huyhoang-1501/Graduation_Thesis/assets/block_diagram.png

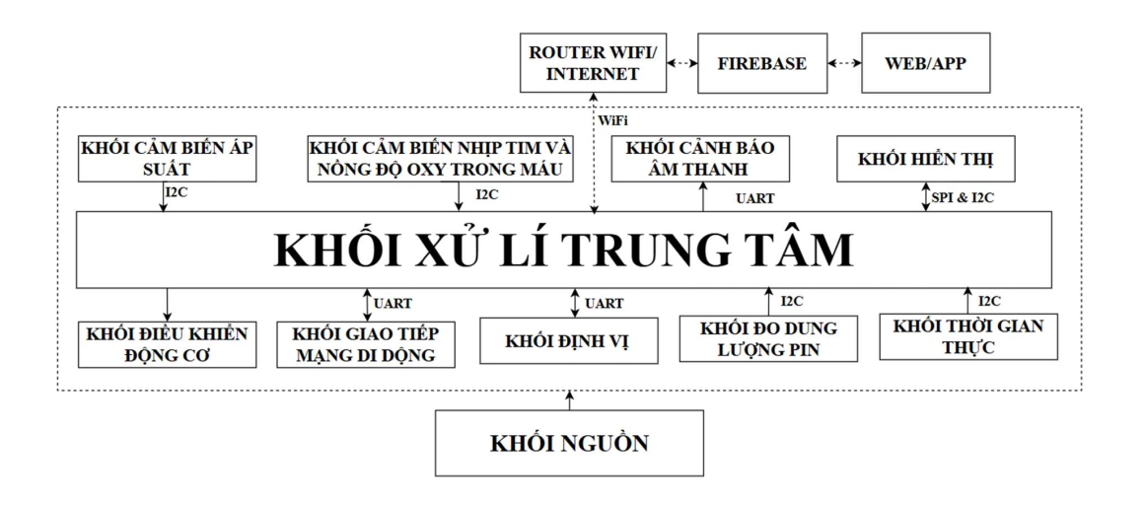
assets/block_diagram.png
