huyhoang-1501/Graduation_Thesis/assets/idea.webp

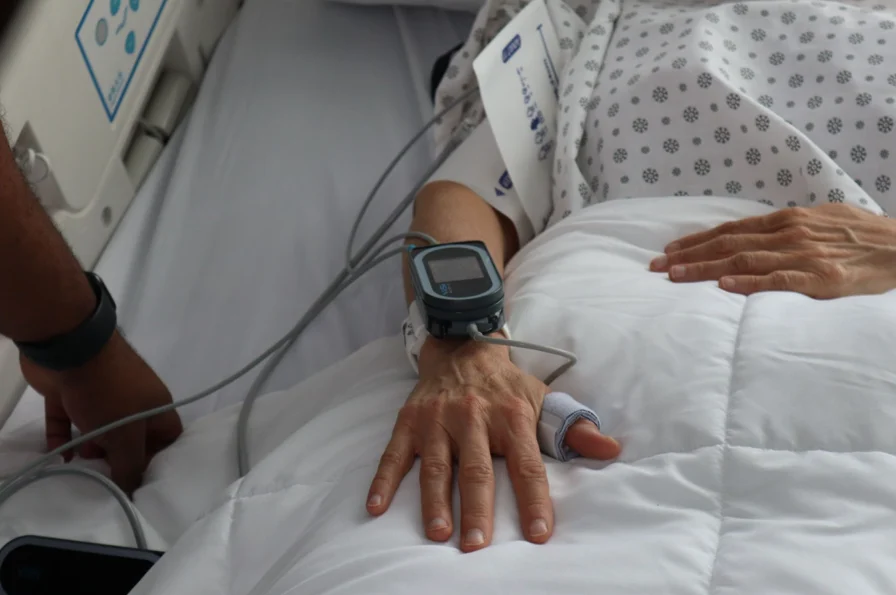
assets/idea.webp
