huyhoang-1501/Graduation_Thesis/assets/Machhoanthien.png

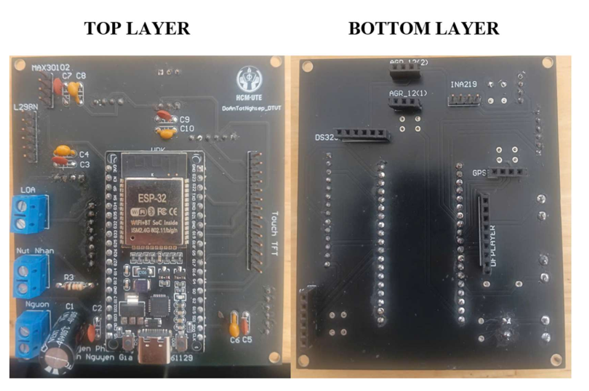
assets/Machhoanthien.png
