huyhoang-1501/Graduation_Thesis/assets/overview.jpg

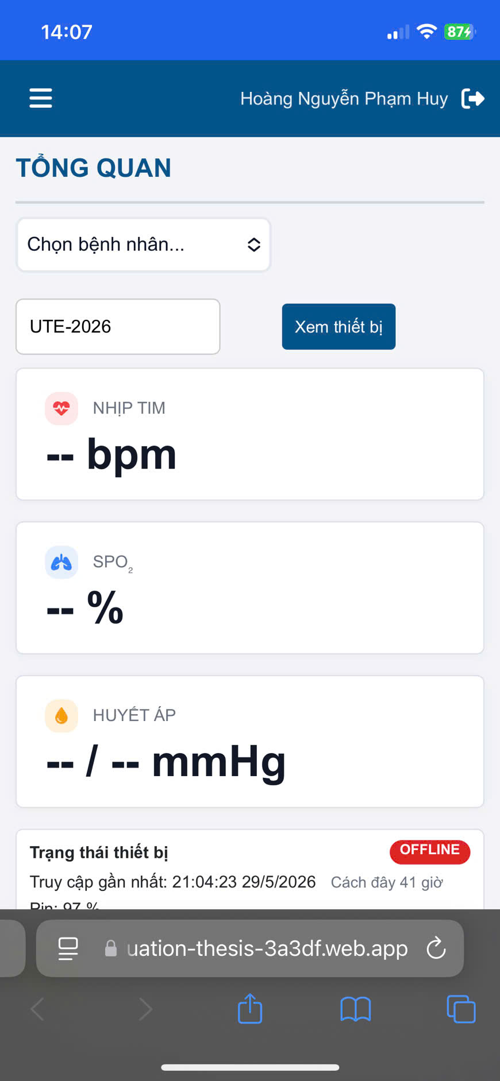
assets/overview.jpg
