huyhoang-1501/Graduation_Thesis/assets/Poster.png

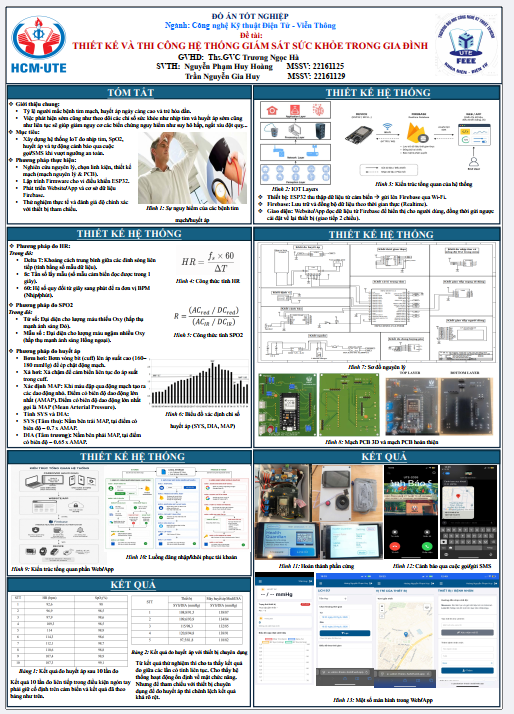
assets/Poster.png
