huyhoang-1501/Graduation_Thesis/WEB/image/healthcare.png

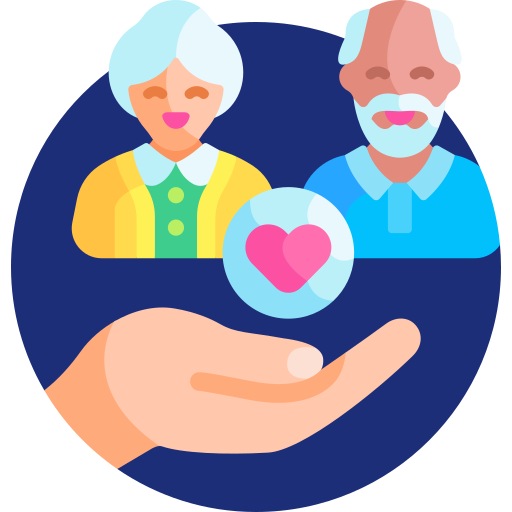
WEB/image/healthcare.png
