huyhoang-1501/Graduation_Thesis/Schematic/Schematic_Graduation_Thesis/Schematic.pdf

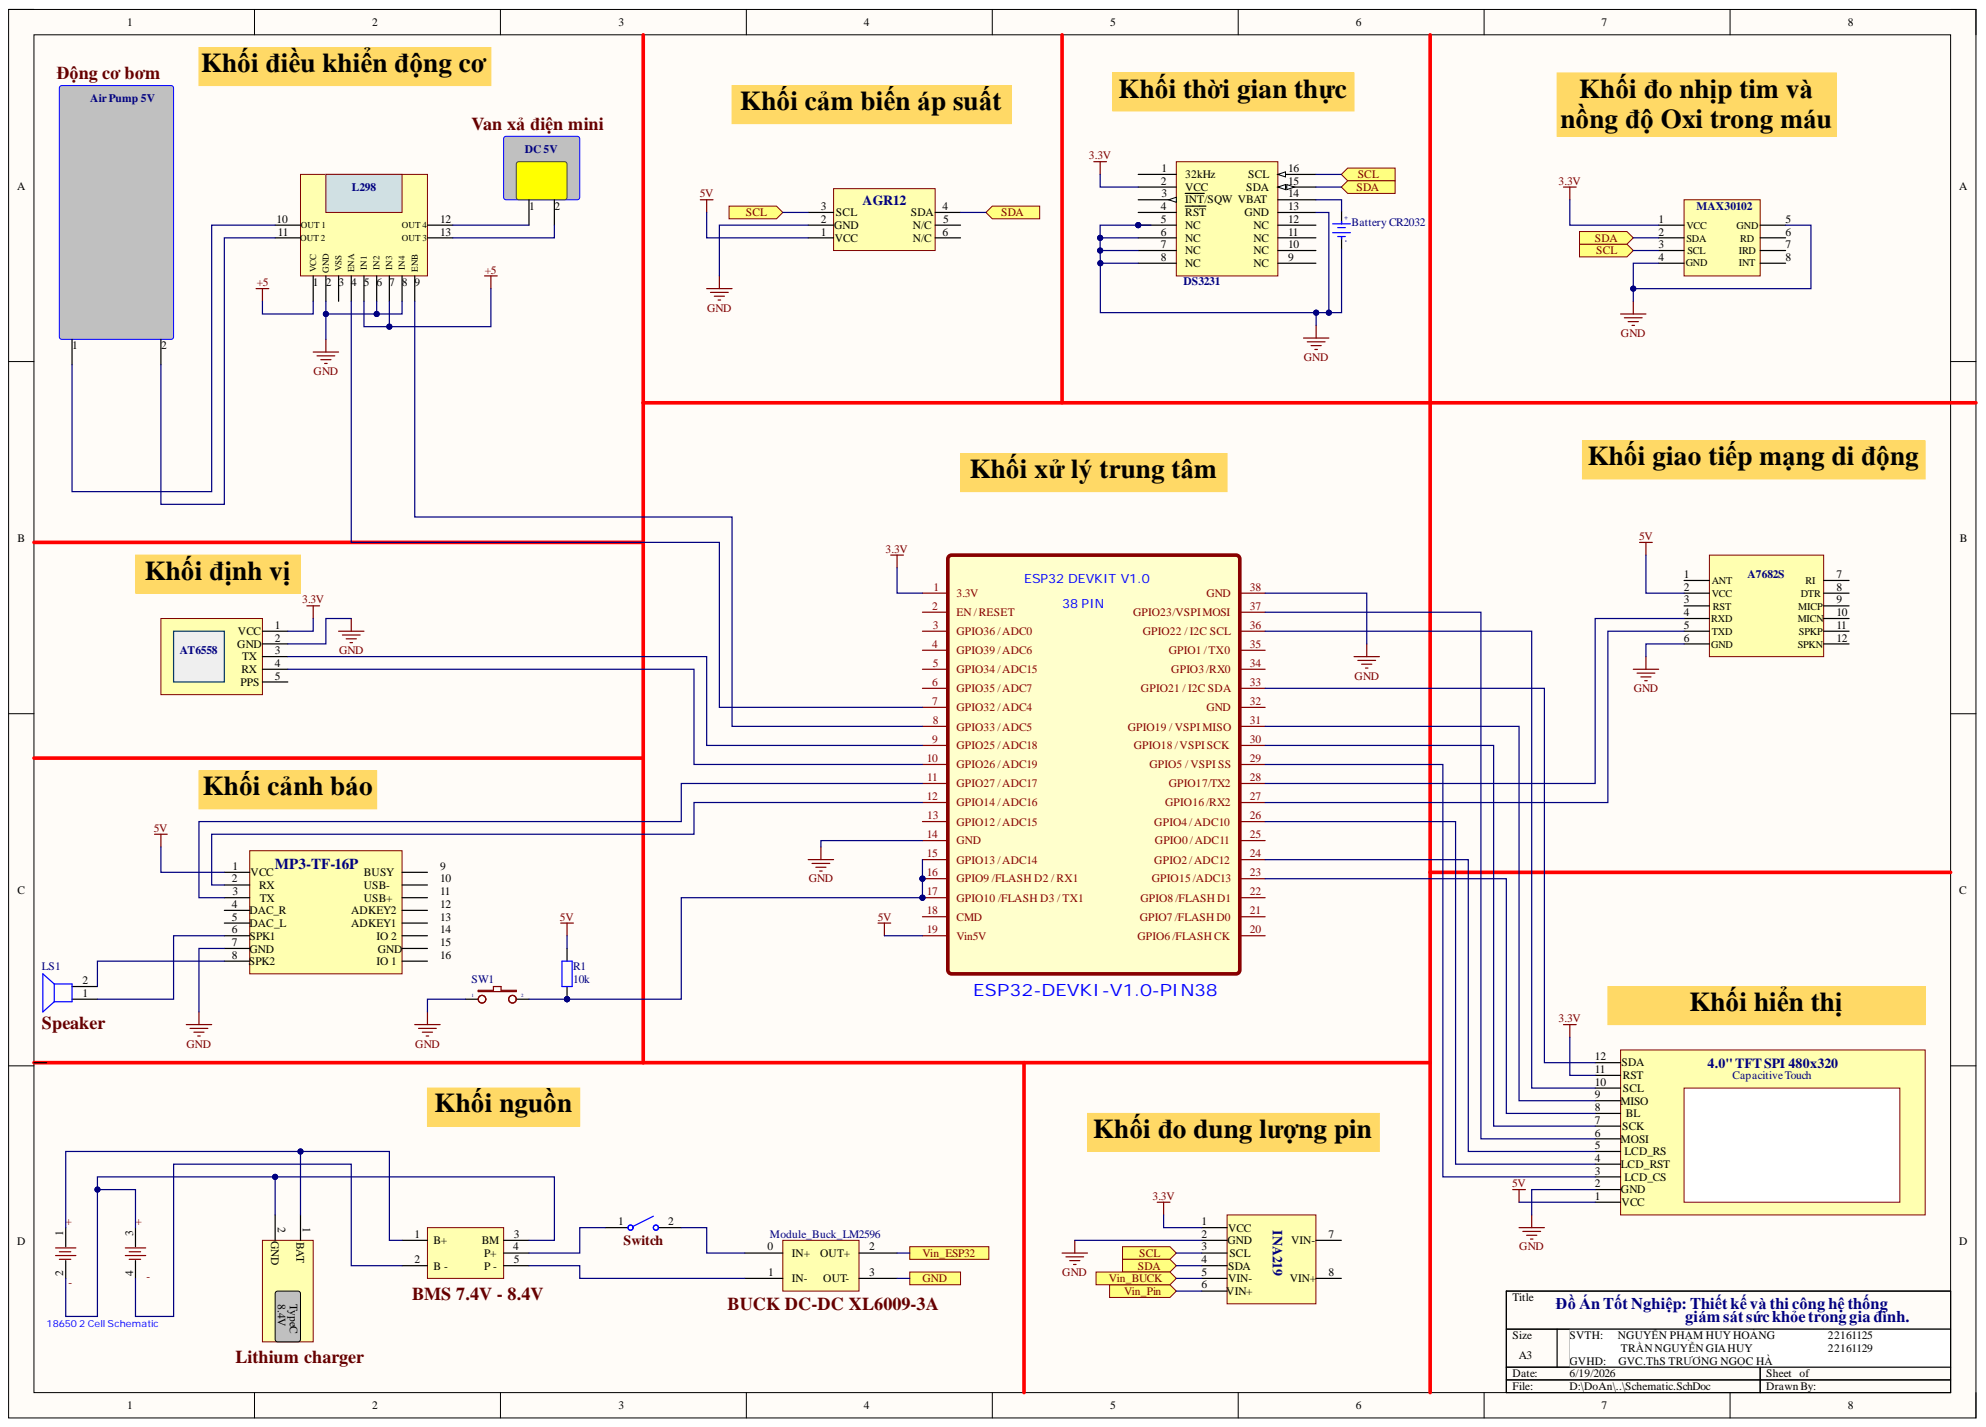
[picture p25: page 1]

Khối điều khiển động cơ

Khối thời gian thực

Khối đo nhịp tim và
nồng độ Oxi trong máu

Khối cảm biến áp suất

Van xả điện mini

GND

Khối giao tiếp mạng di động Khối xử lý trung tâm

Khối đo dung lượng pin | | 7

Title
Đồ Án Tốt Nghiệp: Thiết kế và thi công hệ thống giám sát sức khỏe trong gia đình.

Size A3 | | SVTH: Number NGUYỄN PHẠM HUY HOÀNG TRẦN NGUYỄN GIAHUY GVHD: GVC.ThS TRƯƠNG NGỌC HÀ | 22161125 Revision 22161129

Date: 6/19/2026 | Sheet of
File: D:\DoAn\..\Schematic.SchDoc | Drawn By:
