huyhoang-1501/Graduation_Thesis/(list of files, drawings)

Other design files:
PCB/PCB_Graduation_Thesis/PCB.PcbDoc
PCB/PCB_Graduation_Thesis/PCB_Graduation_Thesis.PrjPcb
PCB/PCB_Graduation_Thesis/Sheet.SchDoc
Schematic/Schematic_Graduation_Thesis/Schematic.SchDoc
