huyhoang-1501/Graduation_Thesis/(commit log)

2026-03-29 Enhance Gui and Pin Map On Telegram
2026-04-04 Add function for History/Alert/Device-Setting
2026-04-08 Add function reading battery capacity
    [Schematic_Graduation_Thesis.PrjPcb]
2026-04-13 Add documentions
    [FT6336U_Register.xlsx]
2026-04-16 Add keypad when click User
    [Schematic.SchDoc, Schematic_Graduation_Thesis.PrjPcb]
2026-04-19 Add code read data ECG from ADS8232 and create module schematic
    [Schematic.SchDoc]
2026-04-21 Add function select patient in the setting
2026-04-21 Replace a single-cell battery with a dual-cell battery.
    [Schematic.SchDoc]
2026-04-21 Add event when press the Guest button on the Main Gui
2026-04-21 Add layout for button Back in the keypad
2026-04-21 Fix the time error on DS3231
    [Main_Gui.ino]
2026-04-21 Develop logic to pair the device with the dashboard
2026-04-22 Remove the mechanism that links the device to the web
2026-04-23 Sync Device with RTDB
2026-04-23 Fix HTTP blocking issues and use thread splitting to optimize task execution
    [FirebaseSync.cpp, Main_Gui.ino, UserMode.cpp]
2026-04-24 Remove the option to deploy on Git
    [Config.txt]
2026-04-24 Optimized interface for mobile devices
2026-04-26 Add the algorithm presentation file for the MAX3010X sensor
2026-04-27 Add module MAX30102 on Altium
    [Schematic.SchDoc]
2026-04-28 Verify email when log in
    [Schematic.SchDoc]
2026-04-28 Complete the Schematic
    [Schematic.SchDoc]
2026-04-28 Add file PDF of Schematic
    [Schematic.SchDoc]
2026-04-29 Adjust the pins for the SIM module, GPS module, alarm unit, and blood pressure measurement unit
    [Schematic.SchDoc, Schematic_Graduation_Thesis.PrjPcb]
2026-04-29 Define pins of battery capacity measurement module and heart rate and SPO2 measurement module
    [PCB.PcbDoc, PCB_Graduation_Thesis.PrjPcb, Schematic.SchDoc, Sheet.SchDoc]
2026-04-29 Add schematic of DS3231
    [Schematic.SchDoc, Sheet.SchDoc]
2026-04-30 Implement PCB
    [PCB.PcbDoc, Schematic.SchDoc, Sheet.SchDoc]
2026-05-03 Update PCB
    [PCB.PcbDoc, PCB_Graduation_Thesis.PrjPcb, Sheet.SchDoc]
2026-05-03 Update PCB V2
    [PCB_Graduation_Thesis.PrjPcb, Sheet.SchDoc]
2026-05-04 Adjust the layout for the edit alert button cluster
2026-05-06 Copper overlay and Gerber file export
    [PCB.GBL, PCB.GBO, PCB.GBP, PCB.GBS, PCB.GKO, PCB.GTL, PCB.GTO, PCB.GTP]
2026-05-07 Customize the interface of the buttons on mobile devices
2026-05-08 Add two resistors to the TX and RX pins of DFPlayer
    [PCB.PcbDoc, Sheet.SchDoc]
2026-05-10 Scale data input fields on mobile
    [PCB.PcbDoc, Sheet.SchDoc]
2026-05-10 Add a materials and components list
    [Vatulinhkien_DATN.xlsx]
2026-05-10 Adjust the height of the data entry fields in the Devices/Patients section
2026-05-10 Add function read BP, HR, SPO2 on Main Gui
    [PCB.PcbDoc, Sheet.SchDoc, Vatulinhkien_DATN.xlsx]
2026-05-10 Reduce the size of the cells in the device/patient
2026-05-10 Add button Start on Guest and User mode
2026-05-10 Change the position of the start and settings buttons
2026-05-11 Export File Gerber
    [PCB.GBL, PCB.GBO, PCB.GBP, PCB.GBS, PCB.GKO, PCB.GTL, PCB.GTO, PCB.GTP]
2026-05-11 Disable Start button to avoid re-entrancy while measurement runs
    [GuestMode.cpp]
2026-05-12 Remove the Start button logic and delete the virtual display of parameters on the TFT screen
2026-05-12 Remove the 3 modes and switch to Max30102 continuous measurement mode, and the BP block will only activate when type start
2026-05-13 Add filter EMA on Max30102
2026-05-18 Modify the schematic to connect the module directly to the microcontroller
    [Schematic.SchDoc]
2026-05-18 Adjust the position of the battery capacity measurement block on the schematic
    [Schematic.SchDoc]
2026-05-18 modify Schematic
    [Schematic.SchDoc]
2026-05-18 Push information such as device status and battery percentage from the device directory to Firebase and display it on the web overview tab
2026-05-20 Fix mobile patient selection size
2026-05-20 Sync patient selection boxes on mobile
2026-05-21 Sync device with Potral
2026-05-21 Fix status online/offline when connecting to device
2026-05-21 Fix issue sync ID from device to Potral to display parameter
    [FirebaseSync.cpp, FirebaseSync.h, Main_Gui.ino]
2026-05-22 Add a list of components purchased for making the PCB circuit
    [LinhkienlamPCB.xlsx]
2026-05-22 Push file excel
    [LinhkienlamPCB.xlsx]
2026-05-23 Reduce the width of the Patient Selection and DEVICE ID cells in the Overview tab, and reduce the length of the cells in the History tab
2026-05-24 Adjust the width of the patient selection box for the three tabs: overview, history, and settings
2026-05-24 Improved algorithms for max30102 and agr12. Added auto-correction feature for charts when switching to a larger screen
    [GuestMode.cpp, HR_SPO2_BP.cpp, MainUi.cpp]
2026-05-25 Fix firebase id user mode online issue
    [FirebaseSync.cpp, HR_SPO2_BP.cpp]
2026-05-25 Move the start button to the top right corner of the screen and add a mode button next to it in offline mode
2026-05-26 Move the position of the mode and settings buttons and add a mode button to the Mode Online section
2026-05-26 Adjust the position of the text displayed in the four data display frames in online mode
2026-05-27 Add a mode button mechanism in offline mode
2026-05-27 Add pressure measurement functionality to online mode
2026-05-28 Narrow the width of the patient and DEVICE ID selection boxes in the overview tab
2026-05-28 Turn off auto-selecting the first patient
2026-05-28 Adjust the height of the two boxes, the device status box and the notification box, to be the same on mobile
2026-05-29 Synchronize the height for the Device Status and Notification boxes on the mobile overview tab
2026-05-29 Add an auto-selection feature for patients in the history tab
2026-05-29 Draw a discontinuous blood pressure graph
2026-05-29 Add the settings section to the patients field in Realtimedatabase
2026-05-30 Fix the two patient selection boxes and enter the DEVICE ID in the overview tab
    [Config.txt]
2026-06-03 Connect the wires to the pins instead of the ports on the schematic
    [Schematic.SchDoc]
2026-06-05 Rotate the screen 180 degrees
    [Schematic.SchDoc]
2026-06-07 Add GPS to the Device Location tab.
2026-06-08 Added a function to cancel blood pressure measurement using the mode button when measuring in offline mode
2026-06-08 Added function to cacel blood pressure measurement using the mode button ưhen mearsuring in online mode
2026-06-09 Add button SOS
2026-06-09 Complete the function by pressing the SOS button to call and send an alert to the phone number saved in NVS
2026-06-11 Enhance algotithm SYS/DIA of Blood Pressure
2026-06-12 Change path patients/patientsid/measurements
2026-06-12 Add pin 13 to disable the alert function
2026-06-13 Add button settings on mode Offline
2026-06-14 Fix alert sim and gps
    [HR_SPO2_BP.cpp, Main_Gui.ino]
2026-06-14 Replace delay with milliseconds
    [HR_SPO2_BP.cpp, Main_Gui.ino, sim_module.cpp, sim_module.h]
2026-06-15 Sync alert from Realtimedatabase to device
2026-06-17 Add ENA and ENB to control Bump and Valve
2026-06-17 Increase more time for the valve to fully release
2026-06-20 Optimize time to retrieve ID from the real-time database
    [Schematic.SchDoc]
2026-06-20 Fix read capacity Pin
    [Main_Gui.ino]
2026-06-20 Fix the bug when the blood pressure measurement stop
    [HR_SPO2_BP.cpp]
